gaboandres1/line-follower-esp32/hardware/chasis/fuente/viewer_template.html

# Chasis seguidor de línea · ESP32 + BFD-1000

MDF 3 mm · tabla 150 × 190 · ruedas 65 × 26 · 2 × 18650

Isométrica Superior Lateral Frontal Por debajo

Arrastra para girar · rueda o pellizco para acercar

## Componentes

## Alturas desde el piso

Cara inferior de la base

__PLATE_ZB__ mm

Eje de las ruedas

__AXLE__ mm

Rueda loca (34 + 3 separadores)

43 mm

Sensores BFD-1000

__SENSOR_ZB__ mm

Eje de ruedas → sensores

__REACH__ mm

Una sola tabla de MDF: motores, rueda loca y sensor van pegados por debajo; batería, L298N y ESP32 por encima.
