gaboandres1/line-follower-esp32/hardware/chasis/chasis_planos.pdf

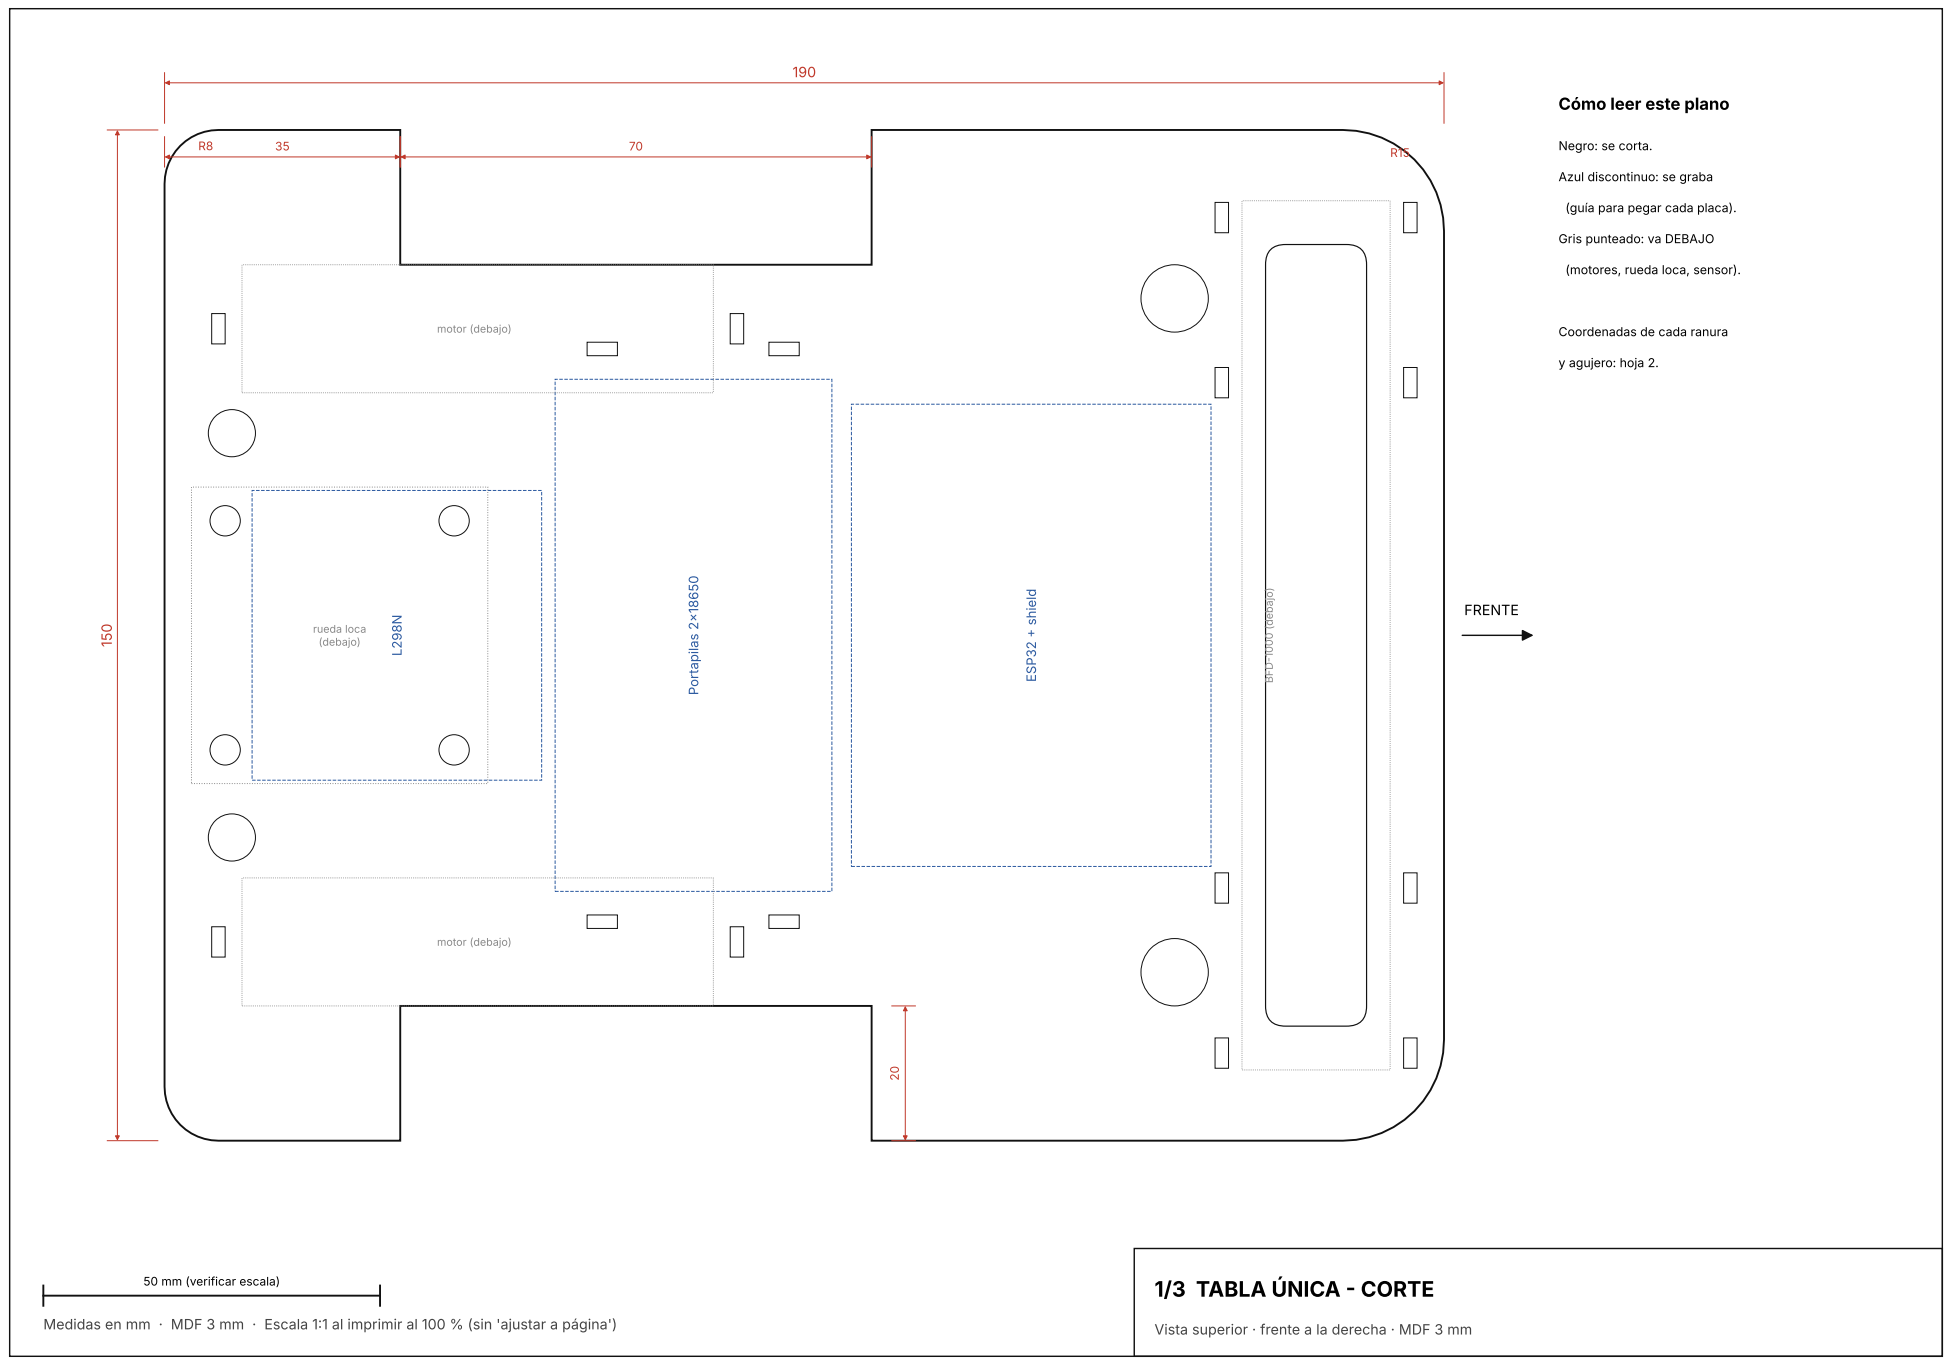
[picture p4: page 1]
Medidas en mm · MDF 3 mm · Escala 1:1 al imprimir al 100 % (sin 'ajustar a página'); Vista superior · frente a la derecha · MDF 3 mm; Portapilas 2x18650; ESP32 + shield; BFD-1000 (debajo); motor (debajo); rueda loca (debajo); FRENTE; y agujero: hoja 2.

Cómo leer este plano

Negro: se corta.

Azul discontinuo: se graba

(guía para pegar cada placa).

Gris punteado: va DEBAJO

(motores, rueda loca, sensor).

Coordenadas de cada ranura

50 mm (verificar escala)

1/3 TABLA ÚNICA - CORTE

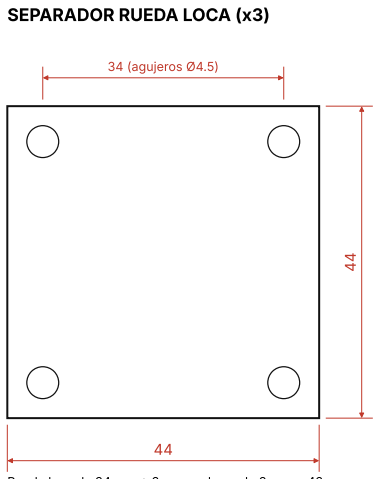
[picture p5: figure]
34 (agujeros Ø4.5); SEPARADOR RUEDA LOCA (x3)

## 2/3 CORTES INTERNOS Y SEPARADORES

Medidas en mm · MDF 3 mm · Escala 1:1 al imprimir al 100 % (sin 'ajustar a página') | Coordenadas al centro, desde la esquina trasera izquierda
# | Elemento | X | Y | Tamaño (X x Y)

1 | Amarre batería | 32.5 | 65.0 | ranura 2 x 4.5
2 | Amarre batería | 117.5 | 65.0 | ranura 2 x 4.5
3 | Amarre batería | 32.5 | 92.0 | ranura 2 x 4.5
4 | Amarre batería | 117.5 | 92.0 | ranura 2 x 4.5
5 | Amarre motor | 29.5 | 8.0 | ranura 4.5 x 2
6 | Amarre motor | 29.5 | 85.0 | ranura 4.5 x 2
7 | Amarre motor | 120.5 | 8.0 | ranura 4.5 x 2
8 | Amarre motor | 120.5 | 85.0 | ranura 4.5 x 2
9 | Amarre sensor | 13.0 | 157.0 | ranura 4.5 x 2
10 Amarre sensor | 13.0 | 185.0 | ranura 4.5 x 2
11 Amarre sensor | 37.5 | 157.0 | ranura 4.5 x 2
12 Amarre sensor | 37.5 | 185.0 | ranura 4.5 x 2
13 Amarre sensor | 112.5 | 157.0 | ranura 4.5 x 2
14 Amarre sensor | 112.5 | 185.0 | ranura 4.5 x 2
15 Amarre sensor | 137.0 | 157.0 | ranura 4.5 x 2
16 Amarre sensor | 137.0 | 185.0 | ranura 4.5 x 2
17 Cables motor | 45.0 | 10.0 | Ø 7
18 Cables motor | 105.0 | 10.0 | Ø 7
19 Cables sensor | 25.0 | 150.0 | Ø 10
20 Cables sensor | 125.0 | 150.0 | Ø 10
21 Rueda loca | 58.0 | 9.0 | Ø 4.5
22 Rueda loca | 58.0 | 43.0 | Ø 4.5
23 Rueda loca | 92.0 | 9.0 | Ø 4.5
24 Rueda loca | 92.0 | 43.0 | Ø 4.5
25 Ventana sensor | 75.0 | 171.0 | 116 x 15, R3

Rueda loca de 34 mm + 3 separadores de 3 mm = 43 mm. La tabla queda a 43.75 mm en las ruedas: queda nivelada. Revisa que los agujeros coincidan con los de tu rueda; si no, márcalos sobre el separador y ajusta con una broca.

8

SEPARADOR PCB (x8)

Uno en cada esquina del L298N y de la shield, para que los pines soldados no toquen la madera.

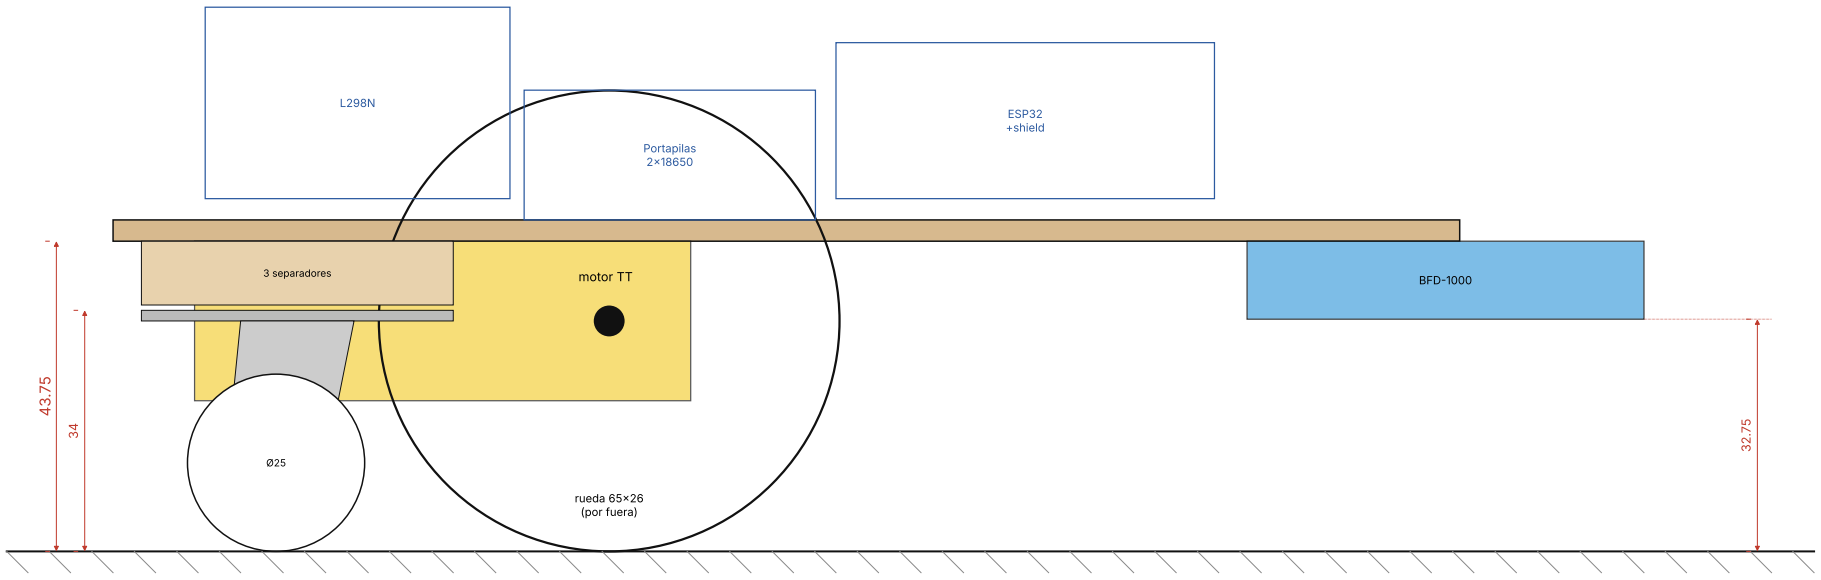
[picture p6: figure]
motor TT; rueda 65×26 (por fuera); 3 separadores; Portapilas 2x18650; ESP32 +shield; BFD-1000

## 3/3 VISTA LATERAL Y ALTURAS

Medidas en mm · MDF 3 mm · Escala 1:1 al imprimir al 100 % (sin 'ajustar a página') | Lado derecho · frente hacia la derecha

tabla 190

eje ruedas → sensores 101

- Con ruedas de 65 mm la tabla queda a 43.75 mm del piso; los sensores, a ~32.75 mm.
- El BFD-1000 detecta hasta unos 30-40 mm según el fabricante: calibra sus potenciómetros

sobre tu pista. Si no distingue bien la línea, pega bloques de 10-15 mm entre la tabla y

los extremos del sensor para bajarlo a unos 15 mm.

- Fija todo con amarres + silicona caliente (o pegamento epóxico para la rueda loca).
