gaboandres1/line-follower-esp32/hardware/chasis/chasis_corte_laser.dxf

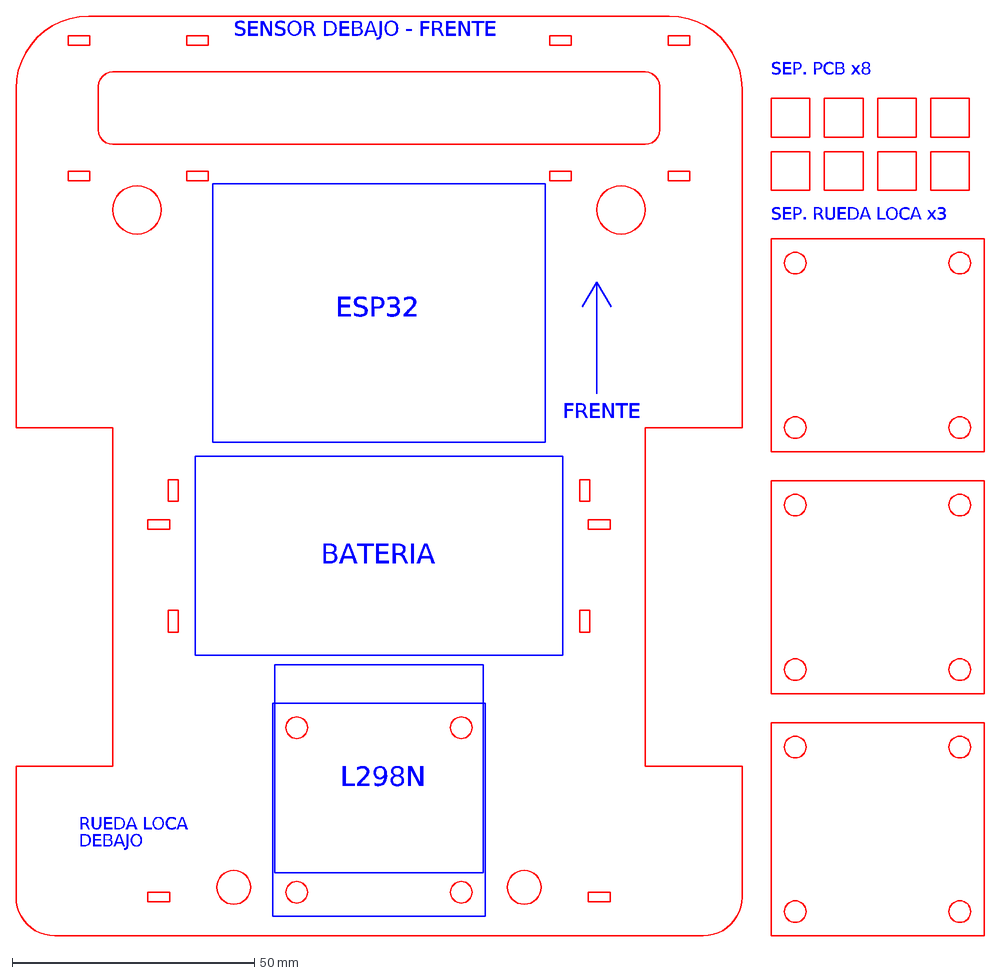
[picture p7: CAD file, 2026-10-16]
hardware/chasis/chasis_corte_laser.dxf
L298N
BATERIA
ESP32
SENSOR DEBAJO - FRENTE
RUEDA LOCA
DEBAJO
FRENTE
SEP. RUEDA LOCA x3
SEP. PCB x8
