gaboandres1/line-follower-esp32/(commit log)

2026-10-16 Agrega firmware seguidor_wifi (cliente WiFi con DHCP o IP fija)
    - Nuevo sketch firmware/seguidor_wifi: se conecta a una red existente,
    sin DNS, con DHCP (imprime la IP por el Monitor Serie) o IP fija.
    Reconexión automática, Enter reimprime la IP y detención opcional
    del robot si se pierde el WiFi.
    - Métricas: muestra señal (dBm) y modo de IP cuando el firmware los envía.
    - build.py genera web_ui.h para seguidor_web y seguidor_wifi.
    - Documentación actualizada (README, panel_web.md, calibracion_y_pid.md).
2026-10-16 Corrige bugs de los firmwares y documenta cada uno
    - seguidor_web / seguidor_wifi:
    - /api/set rechaza valores no numéricos (NaN, inf, texto) con 400;
    al encender se corrigen valores guardados inválidos.
    - BOOT confirma una emergencia (CLP/NEAR) con el robot detenido.
    - La flash solo se escribe con el robot detenido (pausa ambos núcleos);
    el panel muestra "Se guardará al detener el robot".
    - SSID y nombre escapados en el JSON; buffers ampliados.
    - seguidor_wifi: reintento forzado si pasa WIFI_RETRY_MS sin red.
    - seguidor_pid: un choque u obstáculo deja el robot detenido hasta BOOT.
    - Filtro integrador (INPUT_FILTER_N) para CLP y NEAR en los tres seguidores.
    - testbench: i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
2026-10-17 testbench: vacía el buffer serie antes de probar motores
    Un resto del fin de línea del comando podía quedar en el buffer y hacer
    que keyPressed() detuviera el motor a los pocos ms de arrancar: se
    imprimía "Girando..." pero la rueda no se movía. Ahora se descarta antes
    de cada prueba (a, b, paso 3 y t), y spinChannel imprime cuánto giró.
2026-10-17 Busca la línea girando en el lugar en vez de detenerse
    Pasado LOST_TIMEOUT_MS sin ver la línea, los tres seguidores giran en el
    lugar hacia donde la vieron por última vez hasta encontrarla, y retoman
    el PID sin salto del derivativo. Configurable con SEARCH_ON_LOST,
    SEARCH_SPEED y SEARCH_TIMEOUT_MS (0 = sin límite).
    - Panel: aviso "Buscando la línea" (sin confirmar).
    - Métricas: estado "buscando la línea" y contador de búsquedas.
    - Render simulado y documentación actualizados.
    Compilado sin errores ni warnings en el core esp32 más reciente.
